jgilje/BlueSCSI/hw/external-db25/bluepill_scsi.kicad_pcb

## KiCad design hw/external-db25/bluepill_scsi.kicad_pcb (2021-12-19)

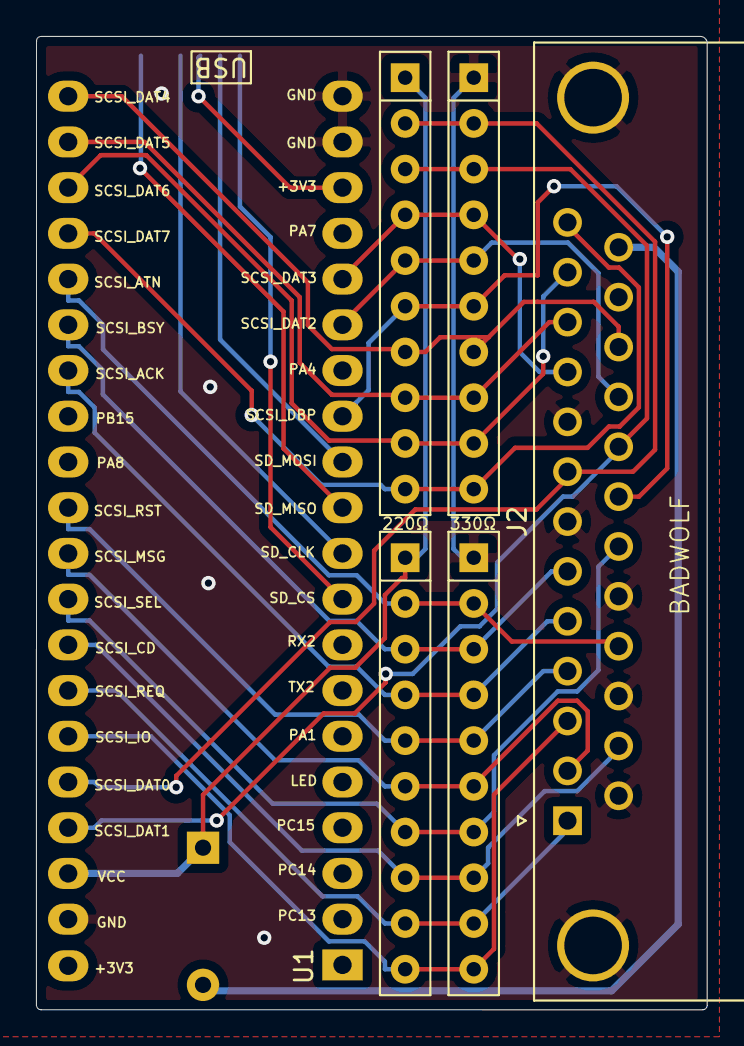
[picture p1: board bluepill_scsi.kicad_pcb from above]

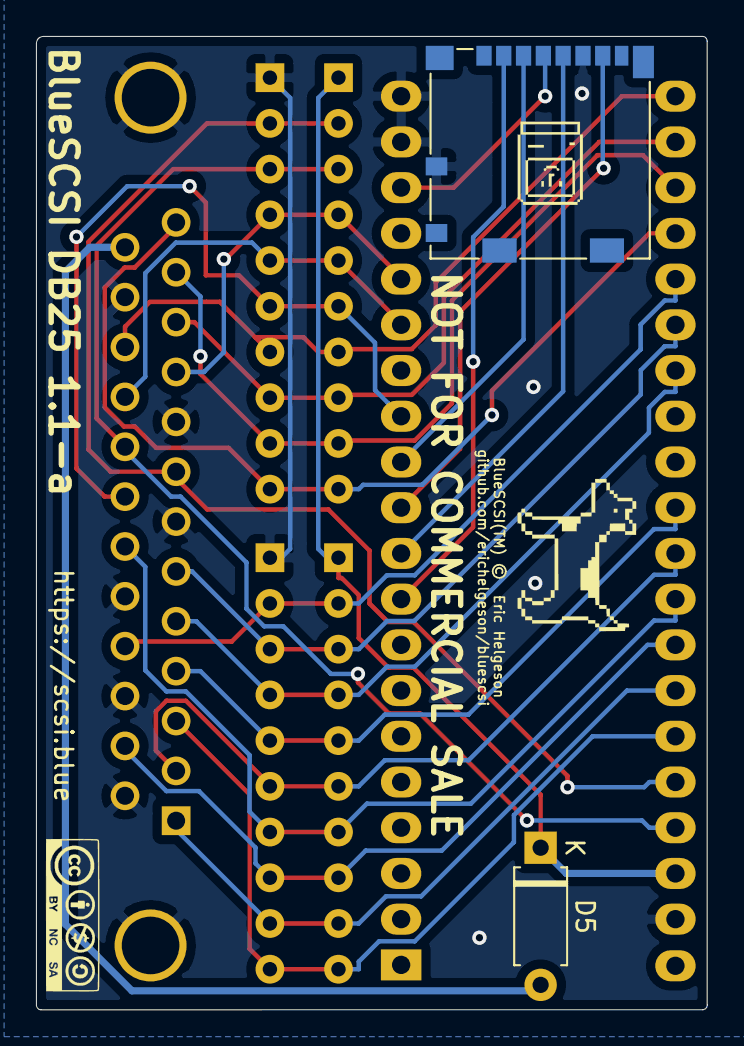
[picture p2: board bluepill_scsi.kicad_pcb from below]

Board: 2 copper layers, 37.3 x 54.1 mm, 11 parts (5 on the bottom side), 26 nets.

Parts:
D5: Diode; D_A-405_P7.62mm_Horizontal
G001: LOGO; dogcow
G002: LOGO; cc_by_nc_sa_front_silk_screen
G004: LOGO; mac_happy_small
J2: DB25_Male_MountingHoles; DSUB-25_Male_Horizontal_P2.77x2.84mm_EdgePinOffset7.70mm_Ho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
J5: Micro_SD_Card; microSD_HC_Molex_104031-0811
RN1, RN3: 220; R_Array_SIP10
RN2, RN4: 330; R_Array_SIP10
U1: BluePill_STM32F103C

Connections:
+3V3: J5.4, U1.18, U1.40
/SCSI_ACK: J2.5, RN3.4, RN4.4, U1.27
/SCSI_ATN: J2.17, RN3.2, RN4.2, U1.25
/SCSI_BSY: J2.6, RN3.3, RN4.3, U1.26
/SCSI_CD: J2.15, RN3.8, RN4.8, U1.33
/SCSI_DAT0: J2.8, RN1.2, RN2.2, U1.36
/SCSI_DAT1: J2.21, RN1.3, RN2.3, U1.37
/SCSI_DAT2: J2.22, RN1.5, RN2.5, U1.15
/SCSI_DAT3: J2.10, RN1.4, RN2.4, U1.16
/SCSI_DAT4: J2.23, RN1.7, RN2.7, U1.21
/SCSI_DAT5: J2.11, RN1.8, RN2.8, U1.22
/SCSI_DAT6: J2.12, RN1.9, RN2.9, U1.23
/SCSI_DAT7: J2.13, RN1.10, RN2.10, U1.24
/SCSI_DBP: J2.20, RN1.6, RN2.6, U1.13
/SCSI_IO: J2.3, RN3.10, RN4.10, U1.35
/SCSI_MSG: J2.2, RN3.6, RN4.6, U1.31
/SCSI_REQ: J2.1, RN3.9, RN4.9, U1.34
/SCSI_RST: J2.4, RN3.5, RN4.5, U1.30
/SCSI_SEL: J2.19, RN3.7, RN4.7, U1.32
/SD_CLK: J5.5, U1.10
/SD_CS: J5.2, U1.9
/SD_MISO: J5.7, U1.11
/SD_MOSI: J5.3, U1.12
/TERM_PWR: D5.2, J2.25
GND: J2.0, J2.7, J2.9, J2.14, J2.16, J2.18, J2.24, J5.6, J5.9, RN2.1, RN4.1, U1.19, U1.20, U1.39
VCC: D5.1, RN1.1, RN3.1, U1.38
