jgilje/BlueSCSI/(commit log)

2021-12-19 Update footprint to Connector_Dsub:DSUB-25_Male_Horizontal_P2.77x2.84mm_EdgePinOffset7.70mm_Housed_MountingHolesOffset9.12mm to make vertical mounting easier
    [bluepill_scsi.kicad_pcb, bluepill_scsi.sch]
2022-06-10 onInquiryCommand(): return unsupported logical unit for both Peripheral Qualifier and Peripheral Device Type if lun is undefined. prevents 8 identical luns appearing on sparcstations
    [BlueSCSI.cpp]
