jgilje/BlueSCSI/(notices)

Notices in the files:
src/BlueSCSI.cpp:
under the terms of the GNU General Public License as published by the
Free Software Foundation, either version 2 of the License, or (at your
permission notice: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
hw/external-db25/bluepill_scsi.kicad_pcb:
BlueSCSI(TM) © Eric Helgeson
